TuanMTruong/Senior_Design/arduino_code/README.md

# gratis

## Sketches

These are example programs that will compile and run on the following platforms

1. TI LaunchPad with M430G2553 using the [Energia](https://github.com/energia) IDE
2. Arduino Leonardo using the [Arduino](http://arduino.cc) IDE

## PlatformWithOS

Contains an example driver and Python demo programs that can be
compiled and run on:

1. [Raspberry Pi](http://www.raspberrypi.org/).
2. [BeagleBone Black](http://www.beagleboard.org/)

======

Gratis is a Repaper.org repository, initiated by E Ink and PDI for the purpose of making sure ePaper can go everywhere.
