TuanMTruong/Senior_Design/proto_blocks/pwr_mgn/eagle_files/pwr_mgn-schematic.jpeg

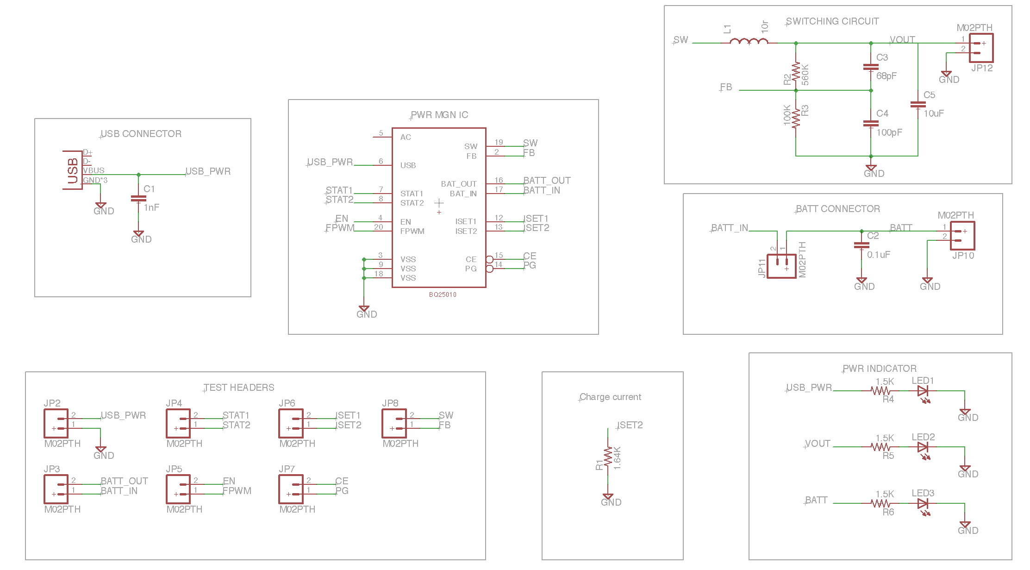
proto_blocks/pwr_mgn/eagle_files/pwr_mgn-schematic.jpeg
