TuanMTruong/Senior_Design/mainboard/BOM.xlsx

Board Ref. | Part Description | Block | Min. Qty. Needed | Qty. Needed + Spares | Cost (per unit) | Line Total | Supplier | Manufacturer Part Number | Purchase Link
BTN_0 - BTN_2 | surface mount/side mounting buttons | Button & LED | 3 | 6 | 0.75 | 4.5 | Digi-key | EVQ-PUK02K | http://www.digikey.com/product-detail/en/EVQ-PUK02K/P10852SCT-ND/286353
R7, R8, R9, R10 | RES 10K OHM 1/16W 5% 0402 | Button & LED | 4 | 12 | 0.02 | 0.24 | Digi-key | RMCF0402JT10K0 | http://www.digikey.com/product-detail/en/RMCF0402JT10K0/RMCF0402JT10K0CT-ND/1942936
R23, R24, R25, R26 | RES 100 OHM 1/16W 1% 0402 SMD | Button & LED | 4 | 12 | 0.1 | 1.2 | Digi-key | RC0402FR-07100RL | http://www.digikey.com/product-detail/en/RC0402FR-07100RL/311-100LRCT-ND/729474
D5, D6, D7, D8 | LED BLUE 0603 SMD | Button & LED | 4 | 12 | 0.47 | 5.64 | Digi-key | LTST-C193TBKT-5A | http://www.digikey.com/product-detail/en/LTST-C193TBKT-5A/160-1827-1-ND/2355044
EPD_CONN | FPC connector | Disp | 1 | 2 | 3.33 | 6.66 | Digi-key | FH12-40S-0.5SH(55) | http://www.digikey.com/product-detail/en/FH12-40S-0.5SH(55)/HFJ140CT-ND/1110388
U10 | AP2305GN P-CH MOSFET | Disp | 1 | 3 | 0.4 | 1.2 | Digi-key | DMG2305UX-13 | http://www.digikey.com/product-detail/en/DMG2305UX-13/DMG2305UX-13DICT-ND/4251589
C20 | 0.1uF 16V Y5V | Disp | 1 | 3 | 0.1 | 0.3 | Digi-key | CL05F104ZO5NNNC | http://www.digikey.com/product-detail/en/CL05F104ZO5NNNC/1276-1004-1-ND/3889090
C14 | 0.1uF 16V X7R | Disp | 1 | 3 | 0.1 | 0.3 | Digi-key | EMK105B7104KV-F | http://www.digikey.com/product-detail/en/EMK105B7104KV-F/587-1451-1-ND/1004082
C21 | 1uF 10V X7R | Disp | 1 | 3 | 0.1 | 0.3 | Digi-key | LMK105BJ105KV-F | http://www.digikey.com/product-detail/en/LMK105BJ105KV-F/587-1454-1-ND/1004085
C3, C19 | 2.2uF 10V Y5V | Disp | 2 | 6 | 0.2 | 1.2 | Digi-key | C0402C225M8PACTU | http://www.digikey.com/product-detail/en/C0402C225M8PACTU/399-7375-1-ND/3317409
C4, C5, C8, C10, C11, C12, C13, C17, C18 | 2.2uF 16V Y5V | Disp | 9 | 27 | 0.32 | 8.64 | Digi-key | C1005X5R1C225M050BC | http://www.digikey.com/product-detail/en/C1005X5R1C225M050BC/445-9076-1-ND/3661603
C6, C8, C9, C15, C16 | 2.2uF 25V Y5V | Disp | 5 | 15 | 0.36 | 5.4 | Digi-key | C1005X5R1E225M050BC | http://www.digikey.com/product-detail/en/C1005X5R1E225M050BC/445-9109-1-ND/3661595
D3 | BAT54SW diode SOT-323(SC-70) | Disp | 1 | 3 | 0.28 | 0.84 | Digi-key | BAT54SWT-TP | http://www.digikey.com/product-detail/en/BAT54SWT-TP/BAT54SWT-TPCT-ND/819661
Q4, Q5 | BSS84W P-CH MOSFET 50V/150mA SOT 23 | Disp | 2 | 6 | 0.22 | 1.32 | Digi-key | BSS84 | http://www.digikey.com/product-detail/en/BSS84/BSS84CT-ND/244297
Q1, Q2, Q3, Q7 | N7002KW N-CH MOSFET | Disp | 4 | 12 | 0.39 | 4.68 | Digi-key | 2N7002W-TP | http://www.digikey.com/product-detail/en/2N7002W-TP/2N7002W-TPMSCT-ND/2041564
R15 | 0 ohm 5% 1/16W | Disp | 1 | 3 | 0.1 | 0.3 | Digi-key | RC0402JR-070RL | http://www.digikey.com/product-detail/en/RC0402JR-070RL/311-0.0JRCT-ND/729353
R11 | 2K 5% 1/10W | Disp | 1 | 3 | 0.1 | 0.3 | Digi-key | ERJ-2GEJ202X | http://www.digikey.com/product-detail/en/ERJ-2GEJ202X/P2.0KJCT-ND/146957
R12, R13, R14 | 100K 5% 1/16W | Disp | 3 | 9 | 0.1 | 0.9 | Digi-key | RC0402JR-07100KL | http://www.digikey.com/product-detail/en/RC0402JR-07100KL/311-100KJRCT-ND/729363
R17 | 33K 5% 1/16W | Disp | 1 | 3 | 0.1 | 0.3 | Digi-key | RC0402JR-0733KL | http://www.digikey.com/product-detail/en/RC0402JR-0733KL/311-33KJRCT-ND/729415
n/a | APDS-9008 light sensor peak wave. 565nm | sensor | 0 | 2 | 1.23 | 2.46 | Digi-key | APDS-9008-020 | http://www.digikey.com/product-detail/en/APDS-9008-020/516-2662-1-ND/3909167
n/a | MCP6001 OPAMP SOT23-5 | sensor | 0 | 4 | 0.29 | 1.16 | Digi-key | MCP6001 | http://www.digikey.com/product-detail/en/MCP6001UT-I%2FOT/MCP6001UT-I%2FOTCT-ND/697159
n/a | LED Green wave. 505nm | sensor | 0 | 5 | 0.67 | 3.35 | Digi-key | WP7113WG1C | http://www.digikey.com/product-detail/en/WP7113WG1C/754-1607-ND/2771874
n/a | LED cyan 505nm | sensor | 0 | 3 | 3.64 | 10.92 | Mouser | LXML-PE01-0060 | http://www.mouser.com/ProductDetail/Philips-Lumileds/LXML-PE01-0060/ | X
n/a | APDS-9006 light sensor peak wave. 500nm | sensor | 0 | 2 | 1.39 | 2.78 | Digi-key | APDS-9006-020 | http://www.digikey.com/product-detail/en/APDS-9006-020/516-1718-1-ND/1785438
L1 | INDUCTOR POWER 10UH 0428 SMD | pwr_mgn | 1 | 3 | 0.88 | 2.64 | Digi-key | ASPI-0428S-100M-T | http://www.digikey.com/product-detail/en/ASPI-0428S-100M-T/ASPI-0428S-100M-TCT-ND/3060211
R1 | RES 56K OHM 1/10W 5% 0402 SMD | pwr_mgn | 1 | 3 | 0.1 | 0.3 | Digi-key | ERJ-2GEJ563X | http://www.digikey.com/product-detail/en/ERJ-2GEJ563X/P56KJCT-ND/147041
R2 | RES 10K OHM 1/10W 5% 0402 SMD | pwr_mgn | 1 | 3 | 0.1 | 0.3 | Digi-key | ERJ-2GEJ103X | http://www.digikey.com/product-detail/en/ERJ-2GEJ103X/P10KJCT-ND/146734
R3, R4 | RES 1.5K OHM 1/16W 5% 0402 | pwr_mgn | 2 | 6 | 0.02 | 0.12 | Digi-key | RMCF0402JT1K50 | http://www.digikey.com/product-detail/en/RMCF0402JT1K50/RMCF0402JT1K50CT-ND/2417846
R5 | RES 1.6K OHM 1/16W 5% 0402 | pwr_mgn | 1 | 3 | 0.02 | 0.06 | Digi-key | RMCF0402JT1K60 | http://www.digikey.com/product-detail/en/RMCF0402JT1K60/RMCF0402JT1K60CT-ND/2417847
R6 | RES 10K OHM 1/16W 5% 0402 | pwr_mgn | 1 | 3 | 0.02 | 0.06 | Digi-key | RMCF0402JT10K0 | http://www.digikey.com/product-detail/en/RMCF0402JT10K0/RMCF0402JT10K0CT-ND/1942936
D1, D2 | LED RED ORAN CLEAR THIN 0603 SMD | pwr_mgn | 2 | 10 | 0.29 | 2.9 | Digi-key | LTST-C191KFKT | http://www.digikey.com/product-detail/en/LTST-C191KFKT/160-1445-1-ND/386832
D9 | DIODE FAST REC 400V 1A MINISMA | pwr_mgn | 1 | 3 | 0.46 | 1.38 | Digi-key | CFRM104-HF | http://www.digikey.com/product-detail/en/CFRM104-HF/641-1487-1-ND/4248870
C2 | CAP CER 10UF 6.3V 10% X5R 0603 | pwr_mgn | 1 | 3 | 0.44 | 1.32 | Digi-key | C1608X5R0J106K080AB | http://www.digikey.com/product-detail/en/C1608X5R0J106K080AB/445-7492-1-ND/2733564
JP1 | CONN RCPT STD MICRO USB TYPE B | pwr_mgn | 1 | 3 | 0.79 | 2.37 | Digi-key | 10104110-0001LF | http://www.digikey.com/product-detail/en/10104110-0001LF/609-4052-1-ND/2350358
U3 | Li-ON pwr management | pwr_mgn | 1 | 3 | 0 | 0 | TI | BQ25010 | http://www.ti.com/product/bq25010
U2 | Bluetooth communication IC | bluetooth | 1 | 1 | 15.95 | 15.95 | Sparkfun | RN-42 | https://www.sparkfun.com/products/10253
C30, C25 | CAP CER 0.47UF 25V Y5V 0603 | mcu | 2 | 6 | 0.1 | 0.6 | Digi-key | TMK107F474ZA-T | http://www.digikey.com/product-detail/en/TMK107F474ZA-T/587-1259-1-ND/931036
U1 | 16 bit mcu MSP430F5528 | mcu | 1 | 3 | 0 | 0 | TI | MSP430F5528 | http://www.ti.com/product/msp430f5528
X1 | 32.768 Khz Crystal | mcu | 1 | 2 | 1.31 | 2.62 | Digi-key | ECS-.327-6-17X-TR | http://www.digikey.com/product-detail/en/ECS-.327-6-17X-TR/XC1307CT-ND/827771
C31, C32 | 12pF caps | mcu | 2 | 6 | 0.1 | 0.2 | Digi-key | CL05C120JB5NNNC | http://www.digikey.com/product-detail/en/CL05C120JB5NNNC/1276-1178-1-ND/3889264
R19, R20, R22 | RES 10K OHM 1/16W 5% 0402 | pwr_mon | 3 | 9 | 0.02 | 0.18 | Digi-key | RMCF0402JT10K0 | http://www.digikey.com/product-detail/en/RMCF0402JT10K0/RMCF0402JT10K0CT-ND/1942936
R21 | RES 1.8M OHM 1/10W 5% 0402 SMD | pwr_mon | 1 | 3 | 0.1 | 0.3 | Digi-key | ERJ-2GEJ185X | http://www.digikey.com/product-detail/en/ERJ-2GEJ185X/P1.8MJCT-ND/146923
R18 | RES 0.01 OHM 1/8W 1% 0402 | pwr_mon | 1 | 2 | 1.04 | 2.08 | Digi-key | CSRF0402FT10L0 | http://www.digikey.com/product-detail/en/CSRF0402FT10L0/CSRF0402FT10L0CT-ND/3945095
U9 | System-Side Impedance Trac Fuel Gauge | pwr_mon | 1 | 3 | 0 | 0 | TI | BQ27410 | http://www.ti.com/product/bq27410-g1
C1, C22, C23, C24, C26, C27, C28, C29 | CAP CER 0.1UF 10V 10% X5R 0402 | all blocks | 8 | 24 | 0.1 | 2.4 | Digi-key | C1005X5R1A104K050BA | http://www.digikey.com/product-detail/en/C1005X5R1A104K050BA/445-1265-1-ND/567732
 |  |  |  |  | Total (min. needed) | 39.69
 |  |  |  |  | TOTAL | 100.67
