TuanMTruong/Senior_Design/mcu_code/epd/EPD_BOM.xlsx

EPD-extension-board-05-03
Item | Name | Description | Type | Vender | Q'ty | Reference Designator | Remark
1 | SMD CAP | 0.1uF 16V | 0402/Y5V |  | 3 | C3,C7,C9
2 | SMD CAP | 0.1uF 16V | 0603/Y5V |  | 3 | C8,C27,C29
3 | SMD CAP | 0.1uF 16V | 0603/X7R |  | 1 | C26
4 | SMD CAP | 1uF 10V | 0805/X7R |  | 1 | C21
5 | SMD CAP | 2.2uF 10V | 0805/Y5V |  | 2 | C1,C10,
6 | SMD CAP | 2.2uF 16V | 0805/Y5V |  | 11 | C11,C12,C14,C17,C18,C19,C20,C24,C25,C28,C30
7 | SMD CAP | 2.2uF 25V | 0805/Y5V |  | 5 | C13,C15,C16,C22,C23
8 | Diode | DIODE BAT54SW | SOT-323(SC-70) |  | 1 | D1
9 | FPC connector | CONN 089H40-000000-G2-C | ZIF-40-0.5-1 |  | 1 | J4 | http://www.mouser.com/Search/ProductDetail.aspx?qs=nSryOFbzj8KFWylXg1bheA%3D%3D
10 | MOSFET | T/R AP2305GN P-CH | SOT23 |  | 1 | Q1
11 | MOSFET | MOSFET BSS84W P-Channel 50V/150mA | SOT-323 |  | 2 | Q3,Q7
12 | MOSFET | MOSFET @N7002KW N-Channel | SOT-323 |  | 9 | Q2,Q4,Q5,Q6,Q8,Q9,Q10,Q11,Q12 | NC:Q13,Q14
13 | SMD RES | 0 ohm | 0603 5% 1/16W |  | 2 | R32,R33 | NC:R34
14 | SMD RES | 2K ohm | 0603 5% 1/10W |  | 1 | R9
15 | SMD RES | 26.7K ohm | 0603 1% 1/10W |  | 1 | R4
16 | SMD RES | 17.8K ohm | 0603 1% 1/10W |  | 1 | R5
17 | SMD RES | 4.7k ohm | 0603 5% 1/16W |  | 1 | R16
18 | SMD RES | 100k ohm | 0402 5% 1/16W |  | 3 | R10,R11,R12
19 | SMD RES | 33k ohm | 0402 5% 1/16W |  | 1 | R1 | NC:R2
20 | SMD RES | 0 ohm | 0402 5% 1/16W |  | 8 | R6,R7,R8,R13,R14,R15,R28,R29 | NC: R3,R35,R36,R37,R38,R39
21 | SMD RES | 4.7k ohm | 0402 5% 1/16W |  | 9 | R17,R18,R19,R20,R21,R22,R23,R24,R25 | NC:R26,R27,R30,R31
22 | IC | S-5813A-I4T1G |  | Seiko | 1 | U1
23 | IC | MX25V8006M1I-13G SOP-8 Flash |  | MXIC | 1 | U2
24 | IC | TPS77030 | SOT23-5 | TI | 1 | U3
25 | Connector | 排母 P2.54 SMT 1*10 H7.1 B TYPE GP |  |  | 2 | J1,J2 | FH.P2.54.SMT.1*10.H7.1mm.B type.G.ARC.5F12134BJ1900110
26 | Connector | Box Header P2.54 90 degress 2*10 GP |  |  | 1 | J3 | BH.P2.54.90度.2*10.平底型.G.ARC.5B12124G22300210
27 | PCB | EPD-extension-board-05 |  |  | 1 | PCB/EPD-extension-board-05
 |  |  |  |  | 74
