TuanMTruong/Senior_Design/proto_blocks/mcu/eagle_files/BOM.xlsx

Quantity | Ref | Description | Supplier | Supplier number | Manufacturer | Manufacturer Part Number | Unit Cost | Extended Cost
1 | C1 | CAP CER 0.47UF 25V Y5V 0603 | Digi-Key | 587-1259-1-ND | Taiyo Yuden | TMK107F474ZA-T | 0.1 | 0.1
2 | C2, C3 | CAP CER 0.1UF 25V Y5V 0603 | Digi-Key | 1276-1011-1-ND | Samsung Electro-Mechanics America, Inc | CL10F104ZA8NNNC | 0.1 | 0.3
4 | R1-R4 | RES 1.5K OHM 1/10W 5% 0603 | Digi-Key | RMCF0603JT1K50CT-ND | Stackpole Electronics Inc | RMCF0603JT1K50 | 0.02 | 0.08
1 | U1 | 16-Bit Ultra-Low-Power Microcontroller | TI | MSP430F5528 | TI | MSP430F5528 | 3.55 | 3.55
 |  |  |  |  |  | Total |  | 4.03
