TuanMTruong/Senior_Design/proto_blocks/pwr_mgn/eagle_files/BOM.xlsx

Quantity | Ref | Description | Supplier | Supplier number | Manufacturer | Manufacturer Part Number | Unit Cost | Extended Cost
1 | C1 | CAP CER 1000PF 50V 10% X7R 0603 | Digi-Key | 1276-1018-1-ND | Samsung Electro-Mechanics America, Inc | CL10B102KB8NNNC | 0.1 | 0.1
1 | C2 | CAP CER 0.1UF 25V Y5V 0603 | Digi-Key | 1276-1011-1-ND | Samsung Electro-Mechanics America, Inc | CL10F104ZA8NNNC | 0.1 | 0.1
1 | C3 | CAP CER 68PF 50V 1% NP0 0603 | Digi-Key | 399-7945-1-ND | Kemet | C0603C680F5GACTU | 0.22 | 0.22
1 | C4 | CAP CER 100PF 50V 2% NP0 0603 | Digi-Key | 1276-2161-1-ND | Samsung Electro-Mechanics America, Inc | CL10C101GB8NNNC | 0.13 | 0.13
1 | C5 | CAP CER 10UF 6.3V 20% X5R 0603 | Digi-Key | 1276-1119-1-ND | Samsung Electro-Mechanics America, Inc | CL10A106MQ8NNNC | 0.19 | 0.19
1 | JP1 | CONN RCPT STD MICRO USB TYPE B | Digi-Key | 609-4052-1-ND | FCI | 10104110-0001LF | 0.79 | 0.79
1 | L1 | INDUCTOR 10UH 10% 1210 SMD | Digi-Key | PCD1484CT-ND | Panasonic Electronic Components - Semiconductor Products | ELJ-PA100KF | 0.27 | 0.27
1 | LED1, LED2 | LED 1.6X0.8MM 631NM RED CLR SMD | Digi-Key | 754-1359-1-ND | Kingbright Company LLC | APG1608SURKC/T | 0.23 | 0.46
1 | LED3 | LED YELLOW GREEN HI BRT USS 0603 | Digi-Key | P13485CT-ND | Panasonic Electronic Components - Semiconductor Products | LNJ326W83RA | 0.44 | 0.44
1 | R1 | RES 1.62K OHM 1/10W 1% 0603 SMD | Digi-Key | P1.62KHCT-ND | Panasonic Electronic Components - Semiconductor Products | ERJ-3EKF1621V | 0.1 | 0.1
1 | R2 | RES 560K OHM 1/10W 5% 0603 SMD | Digi-Key | P560KGCT-ND | Panasonic Electronic Components - Semiconductor Products | ERJ-3GEYJ564V | 0.1 | 0.1
1 | R3 | RES 100K OHM 1/10W 5% 0603 | Digi-Key | RMCF0603JT100KCT-ND | Stackpole Electronics Inc | RMCF0603JT100K | 0.02 | 0.02
3 | R4, R5, R6 | RES 1.5K OHM 1/10W 5% 0603 | Digi-Key | RMCF0603JT1K50CT-ND | Stackpole Electronics Inc | RMCF0603JT1K50 | 0.02 | 0.06
1 | U1 | Single Chip Charger and DC/DC Converter IC | TI | BQ25010 | TI | BQ25010 | 3.89 | 3.89
 |  |  |  |  |  | Total |  | 6.87
