TuanMTruong/Senior_Design/(list of files, cad)

Other CAD files:
proto_blocks/bt_breakout/bt_441-tcream.dxf
proto_blocks/mcu/eagle_files/mcu_block.job-bcream.dxf
proto_blocks/pwr_mgn/eagle_files/pwr_block-tcream.dxf
proto_blocks/bt_breakout/bt_441-bcream.dxf
proto_blocks/mcu/eagle_files/mcu_block.job-tcream.dxf
proto_blocks/pwr_mgn/eagle_files/pwr_block-bcream.dxf
