TuanMTruong/Senior_Design/proto_blocks/sensor/sensor_2.pdf

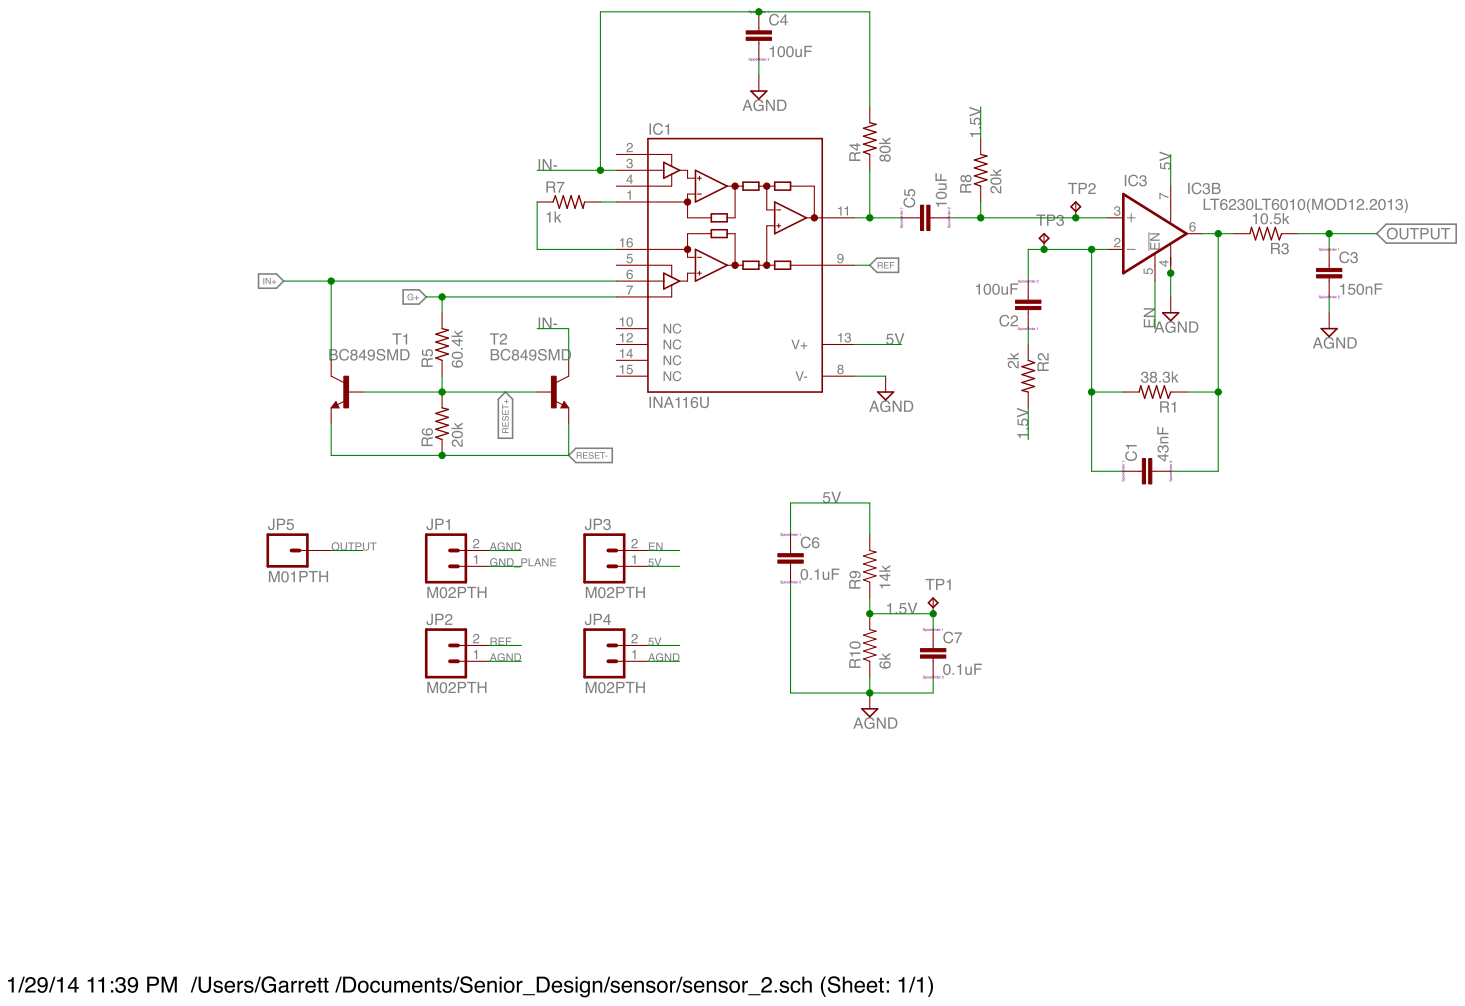
[picture p2: page 1]
