TuanMTruong/Senior_Design/proto_blocks/mcu/eagle_files/mcu_block.pdf

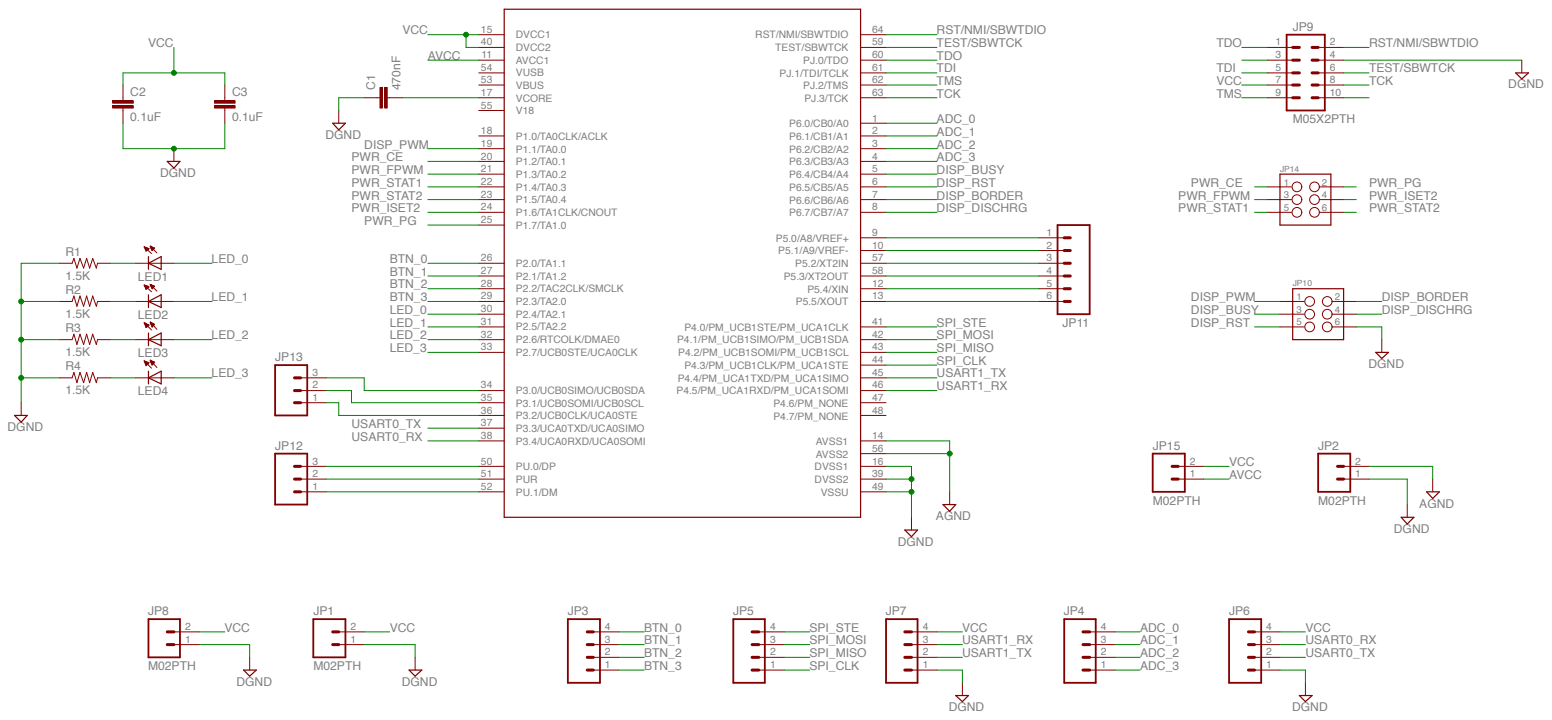
[picture p3: page 1]
