TuanMTruong/Senior_Design/proto_blocks/mcu/eagle_files/mcu_block.brd

## EAGLE design proto_blocks/mcu/eagle_files/mcu_block.brd (2013-12-21)

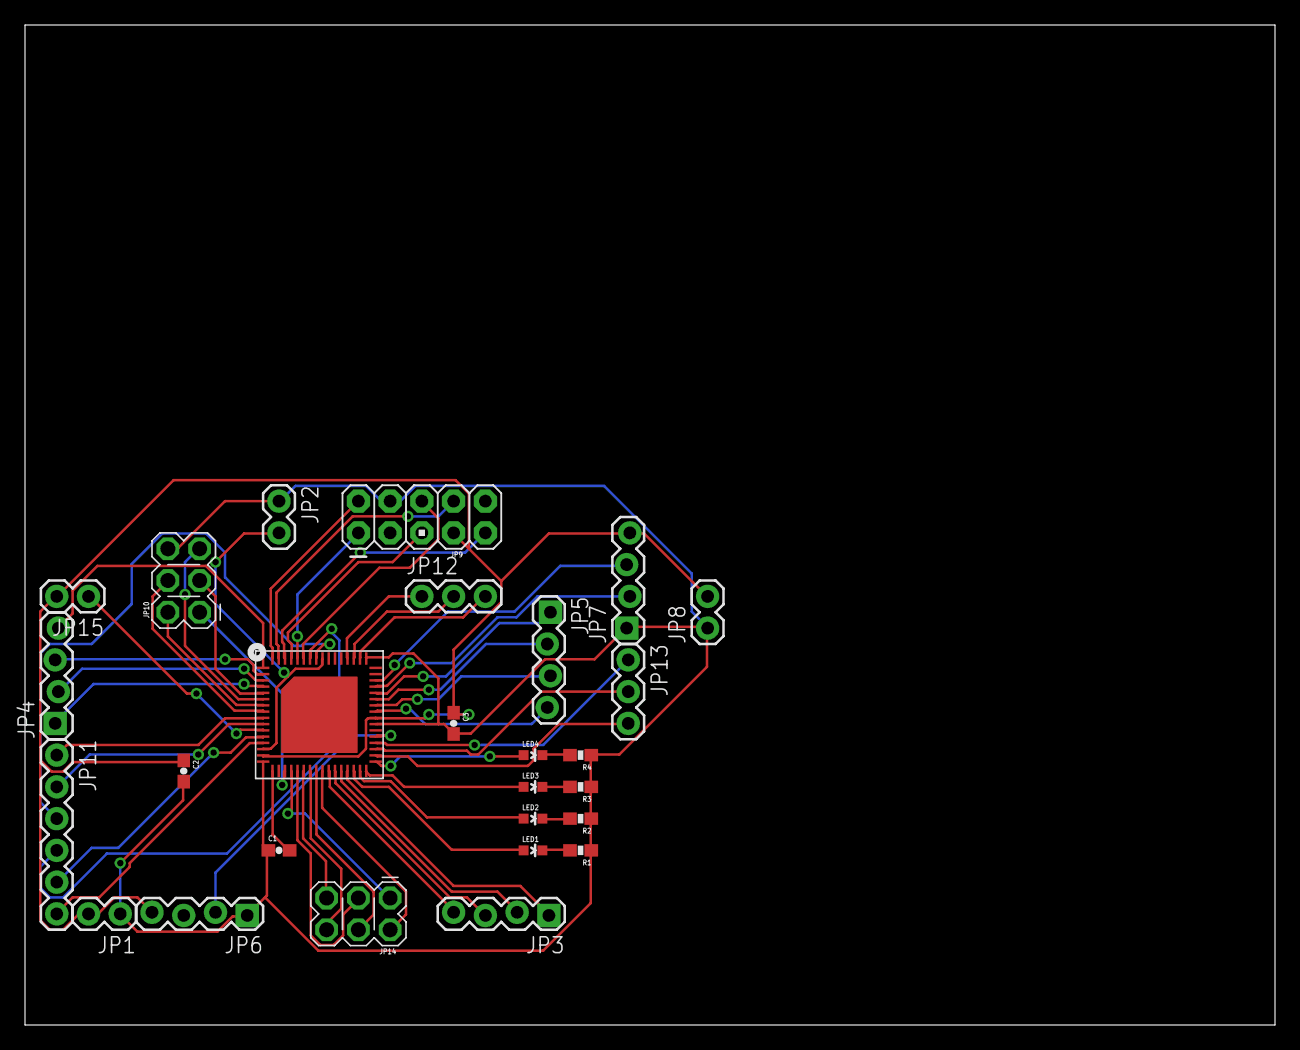
[picture p4: board mcu_block.brd from above]

Board: 2 copper layers, 100.0 x 80.0 mm, 27 parts (0 on the bottom side), 58 nets.

Parts:
C1: 470nF; 0603-CAP
C2, C3: 0.1uF; 0603-CAP
JP1, JP2, JP8, JP15: M02PTH; 1X02
JP3, JP4, JP5, JP6, JP7: 1X04_LOCK
JP9: M05X2PTH; AVR_ICSP
JP10, JP14: 2X3_POGO
JP11: 1X06
JP12, JP13: 1X03
LED1, LED2, LED3, LED4: LED-0603
R1, R2, R3, R4: 1.5K; 0603-RES
U$1: MSP430F5528; VQFN_RGC_64PIN

Connections:
ADC_0: JP4.4, U$1.1
ADC_1: JP4.3, U$1.2
ADC_2: JP4.2, U$1.3
ADC_3: JP4.1, U$1.4
AGND: JP2.2, U$1.14, U$1.56
AVCC: JP15.1, U$1.11
BTN_0: JP3.4, U$1.26
BTN_1: JP3.3, U$1.27
BTN_2: JP3.2, U$1.28
BTN_3: JP3.1, U$1.29
DGND: C1.1, C2.2, C3.2, JP1.1, JP2.1, JP6.1, JP7.1, JP8.1, JP9.4, JP10.P$6, R1.1, R2.1, R3.1, R4.1, U$1.16, U$1.39, U$1.49
DISP_BORDER: JP10.P$2, U$1.7
DISP_BUSY: JP10.P$3, U$1.5
DISP_DISCHRG: JP10.P$4, U$1.8
DISP_PWM: JP10.P$1, U$1.19
DISP_RST: JP10.P$5, U$1.6
LED_0: LED1.A, U$1.30
LED_1: LED2.A, U$1.31
LED_2: LED3.A, U$1.32
LED_3: LED4.A, U$1.33
unnamed: C1.2, U$1.17
unnamed: LED4.C, R4.2
unnamed: JP11.1, U$1.9
unnamed: JP11.2, U$1.10
unnamed: JP11.3, U$1.57
unnamed: JP11.4, U$1.58
unnamed: JP11.5, U$1.12
unnamed: JP11.6, U$1.13
unnamed: JP12.3, U$1.50
unnamed: JP12.2, U$1.51
unnamed: JP12.1, U$1.52
unnamed: JP13.1, U$1.36
unnamed: JP13.2, U$1.35
unnamed: JP13.3, U$1.34
unnamed: LED3.C, R3.2
unnamed: LED2.C, R2.2
unnamed: LED1.C, R1.2
PWR_CE: JP14.P$1, U$1.20
PWR_FPWM: JP14.P$3, U$1.21
PWR_ISET2: JP14.P$4, U$1.24
PWR_PG: JP14.P$2, U$1.25
PWR_STAT1: JP14.P$5, U$1.22
PWR_STAT2: JP14.P$6, U$1.23
RST/NMI/SBWTDIO: JP9.2, U$1.64
SPI_CLK: JP5.1, U$1.44
SPI_MISO: JP5.2, U$1.43
SPI_MOSI: JP5.3, U$1.42
SPI_STE: JP5.4, U$1.41
TCK: JP9.8, U$1.63
TDI: JP9.5, U$1.61
TDO: JP9.1, U$1.60
TEST/SBWTCK: JP9.6, U$1.59
TMS: JP9.9, U$1.62
USART0_RX: JP6.3, U$1.38
USART0_TX: JP6.2, U$1.37
USART1_RX: JP7.3, U$1.46
USART1_TX: JP7.2, U$1.45
VCC: C2.1, C3.1, JP1.2, JP6.4, JP7.4, JP8.2, JP9.7, JP15.2, U$1.15, U$1.40
