TuanMTruong/Senior_Design/proto_blocks/pwr_mgn/eagle_files/pwr_block.brd

## EAGLE design proto_blocks/pwr_mgn/eagle_files/pwr_block.brd (2014-01-02)

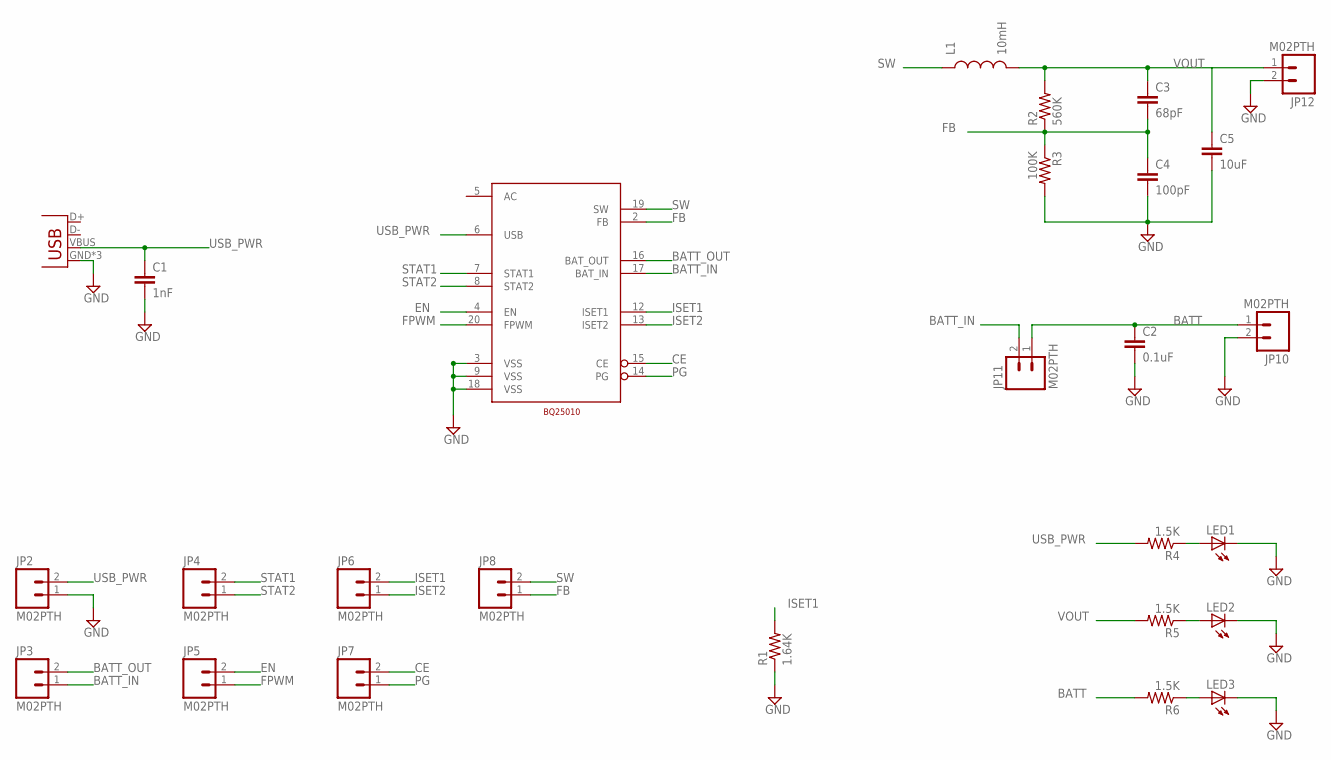
[picture p5: schematic pwr_block.sch]

Parts:
C1: 1nF; 0603-CAP
C2: 0.1uF; 0603-CAP
C3: 68pF; 0603-CAP
C4: 100pF; 0603-CAP
C5: 10uF; 0603-CAP
JP1: USB-MICROB
JP2, JP3, JP4, JP5, JP6, JP7, JP8, JP10, JP11, JP12: M02PTH; 1X02
L1: 10mH; 0603
LED1, LED2, LED3: LED0603; LED-0603
R1: 1.64K; 0603-RES
R2: 560K; 0603-RES
R3: 100K; 0603-RES
R4, R5, R6: 1.5K; 0603-RES
U$1: BQ25010; VQFN_RHL_20PIN

Connections:
BATT: C2.1, JP10.1, JP11.1, R6.2
BATT_IN: JP3.1, JP11.2, U$1.17 (BAT_IN)
BATT_OUT: JP3.2, U$1.16 (BAT_OUT)
CE: JP7.2, U$1.15 (CE)
EN: JP5.2, U$1.4 (EN)
FB: C3.2, C4.1, JP8.1, R2.1, R3.1, U$1.2 (FB)
FPWM: JP5.1, U$1.20 (FPWM)
GND: C1.2, C2.2, C4.2, C5.2, JP1.GND, JP1.MT1 (GND), JP1.MT2 (GND), JP2.1, JP10.2, JP12.2, LED1.C, LED2.C, LED3.C, R1.1, R3.2, U$1.3 (VSS), U$1.9 (VSS), U$1.18 (VSS)
ISET1: JP6.2, R1.2, U$1.12 (ISET1)
ISET2: JP6.1, U$1.13 (ISET2)
unnamed: LED1.A, R4.1
unnamed: LED2.A, R5.1
unnamed: LED3.A, R6.1
PG: JP7.1, U$1.14 (PG)
STAT1: JP4.2, U$1.7 (STAT1)
STAT2: JP4.1, U$1.8 (STAT2)
SW: JP8.2, L1.1, U$1.19 (SW)
USB_PWR: C1.1, JP1.VBUS, JP2.2, R4.2, U$1.6 (USB)
VOUT: C3.1, C5.1, JP12.1, L1.2, R2.2, R5.2

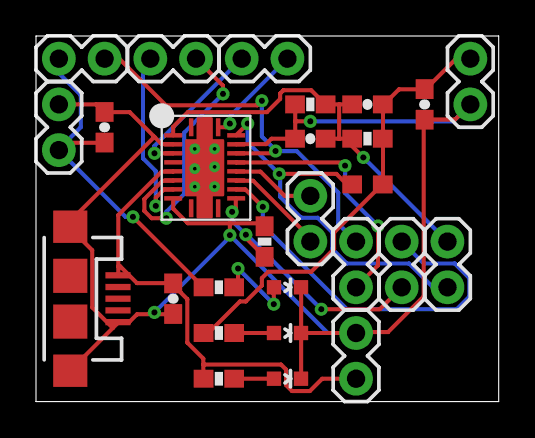
[picture p6: board pwr_block.brd from above]

Board: 2 copper layers, 25.7 x 20.3 mm, 27 parts (0 on the bottom side), 19 nets.
