TuanMTruong/Senior_Design/proto_blocks/bt_breakout/bt_441.brd

## EAGLE design proto_blocks/bt_breakout/bt_441.brd (2014-01-13)

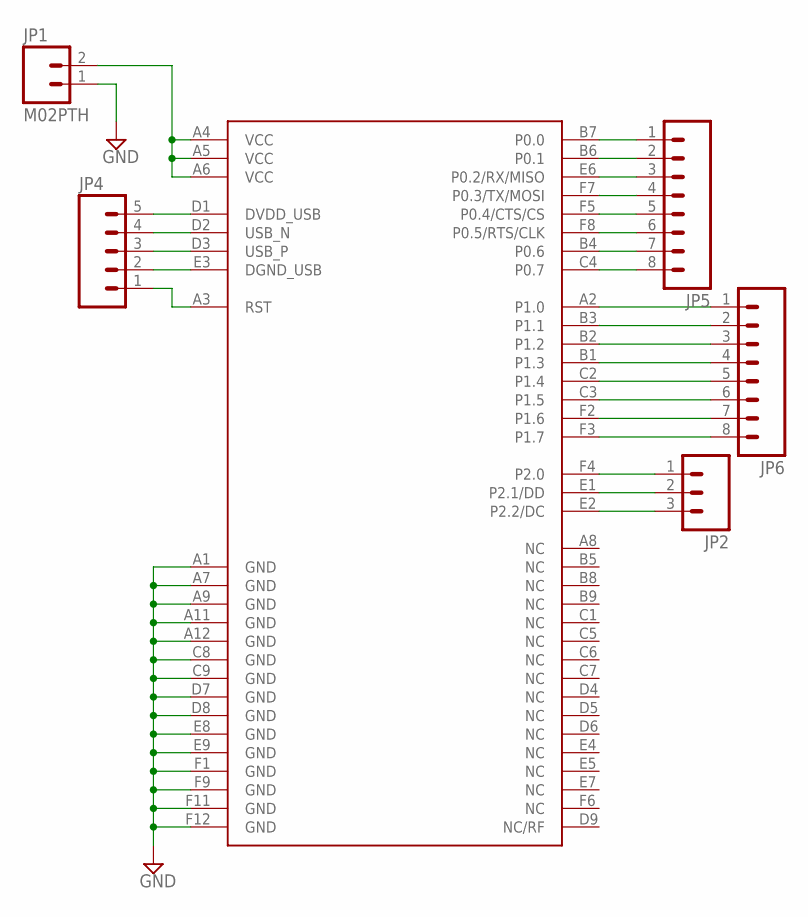
[picture p7: schematic bt_441.sch]

Parts:
JP1: M02PTH; 1X02
JP2: M03PTH; 1X03
JP4: M05PTH; 1X05
JP5, JP6: M081X08; 1X08
U$1: PAN1720

Connections:
GND: JP1.1, U$1.A1 (GND), U$1.A7 (GND), U$1.A9 (GND), U$1.A11 (GND), U$1.A12 (GND), U$1.C8 (GND), U$1.C9 (GND), U$1.D7 (GND), U$1.D8 (GND), U$1.E8 (GND), U$1.E9 (GND), U$1.F1 (GND), U$1.F9 (GND), U$1.F11 (GND), U$1.F12 (GND)
unnamed: JP1.2, U$1.A4 (VCC), U$1.A5 (VCC), U$1.A6 (VCC)
unnamed: JP4.5, U$1.D1 (DVDD_USB)
unnamed: JP4.4, U$1.D2 (USB_N)
unnamed: JP4.3, U$1.D3 (USB_P)
unnamed: JP4.2, U$1.E3 (DGND_USB)
unnamed: JP4.1, U$1.A3 (RST)
unnamed: JP5.1, U$1.B7 (P0.0)
unnamed: JP5.2, U$1.B6 (P0.1)
unnamed: JP5.3, U$1.E6 (P0.2/RX/MISO)
unnamed: JP5.4, U$1.F7 (P0.3/TX/MOSI)
unnamed: JP5.5, U$1.F5 (P0.4/CTS/CS)
unnamed: JP5.6, U$1.F8 (P0.5/RTS/CLK)
unnamed: JP5.7, U$1.B4 (P0.6)
unnamed: JP5.8, U$1.C4 (P0.7)
unnamed: JP6.1, U$1.A2 (P1.0)
unnamed: JP6.2, U$1.B3 (P1.1)
unnamed: JP6.3, U$1.B2 (P1.2)
unnamed: JP6.4, U$1.B1 (P1.3)
unnamed: JP6.5, U$1.C2 (P1.4)
unnamed: JP6.6, U$1.C3 (P1.5)
unnamed: JP6.7, U$1.F2 (P1.6)
unnamed: JP6.8, U$1.F3 (P1.7)
unnamed: JP2.1, U$1.F4 (P2.0)
unnamed: JP2.2, U$1.E1 (P2.1/DD)
unnamed: JP2.3, U$1.E2 (P2.2/DC)

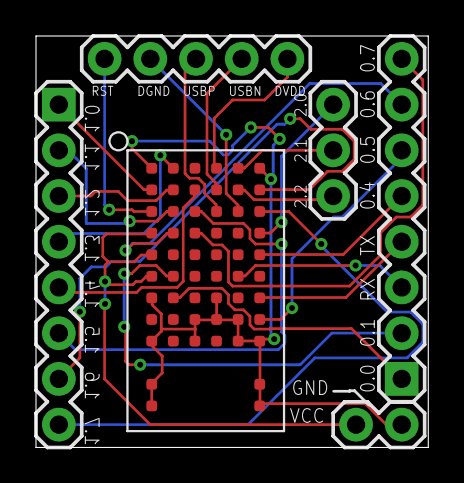
[picture p8: board bt_441.brd from above]

Board: 2 copper layers, 21.8 x 22.9 mm, 6 parts (0 on the bottom side), 26 nets.
