TuanMTruong/Senior_Design/proto_blocks/sensor/sensor_2.brd

## EAGLE design proto_blocks/sensor/sensor_2.brd (2014-01-02)

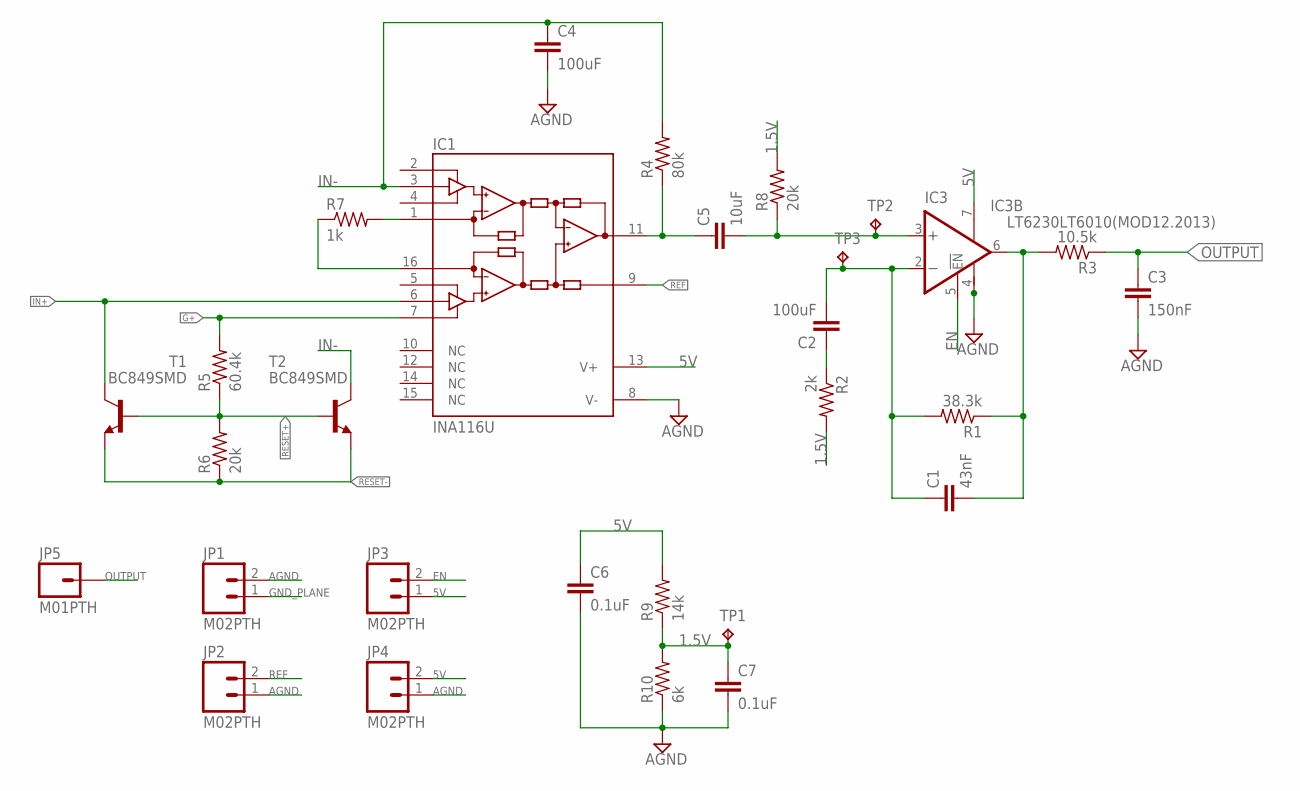
[picture p9: schematic sensor_2.sch]

Parts:
C1: 43nF; C0805
C2, C4: 100uF; C1206
C3: 150nF; C0603
C5: 10uF; C1206
C6, C7: 0.1uF; C0402
IC1: INA116U; SO16-1
IC3: LT6230LT6010(MOD12.2013); DFN8-3X3(MODIFIED12.2013)
JP1, JP2, JP3, JP4: M02PTH; 1X02
JP5: M01PTH; 1X01
R1: 38.3k; R0805
R2: 2k; R0805
R3: 10.5k; R0805
R4: 80k; R0805
R5: 60.4k; R0603
R6, R8: 20k; R0603
R7: 1k; R0402
R9: 14k; 0603-RES
R10: 6k; 1206
T1, T2: BC849SMD; SOT23-BEC
TP1, TP2, TP3: TPPAD1-13; P1-13

Connections:
1.5V: C7.1, R2.2, R8.2, R9.1, R10.2, TP1.TP
5V: C6.1, IC1.13 (V+), IC3.7 (V+), JP3.1, JP4.2, R9.2
AGND: C3.2, C4.2, C6.2, C7.2, IC1.8 (V-), IC3.4 (V-), JP1.2, JP2.1, JP4.1, R10.1
EN: IC3.5 (!EN), JP3.2
G+: IC1.7 (GUARD+), R5.2
GND_PLANE: JP1.1
IN+: IC1.6 (+IN), T1.C
IN-: C4.1, IC1.3 (-IN), R4.2, T2.C
unnamed: IC1.1 (RG), R7.2
unnamed: IC1.16 (RG), R7.1
unnamed: C5.1, IC1.11 (OUT), R4.1
unnamed: C2.1, R2.1
unnamed: C1.1, C2.2, IC3.2 (-IN), R1.2, TP3.TP
unnamed: C5.2, IC3.3 (+IN), R8.1, TP2.TP
unnamed: C1.2, IC3.6 (OUT), R1.1, R3.2
OUTPUT: C3.1, JP5.1, R3.1
REF: IC1.9 (REF), JP2.2
RESET+: R5.1, R6.2, T1.B, T2.B
RESET-: R6.1, T1.E, T2.E

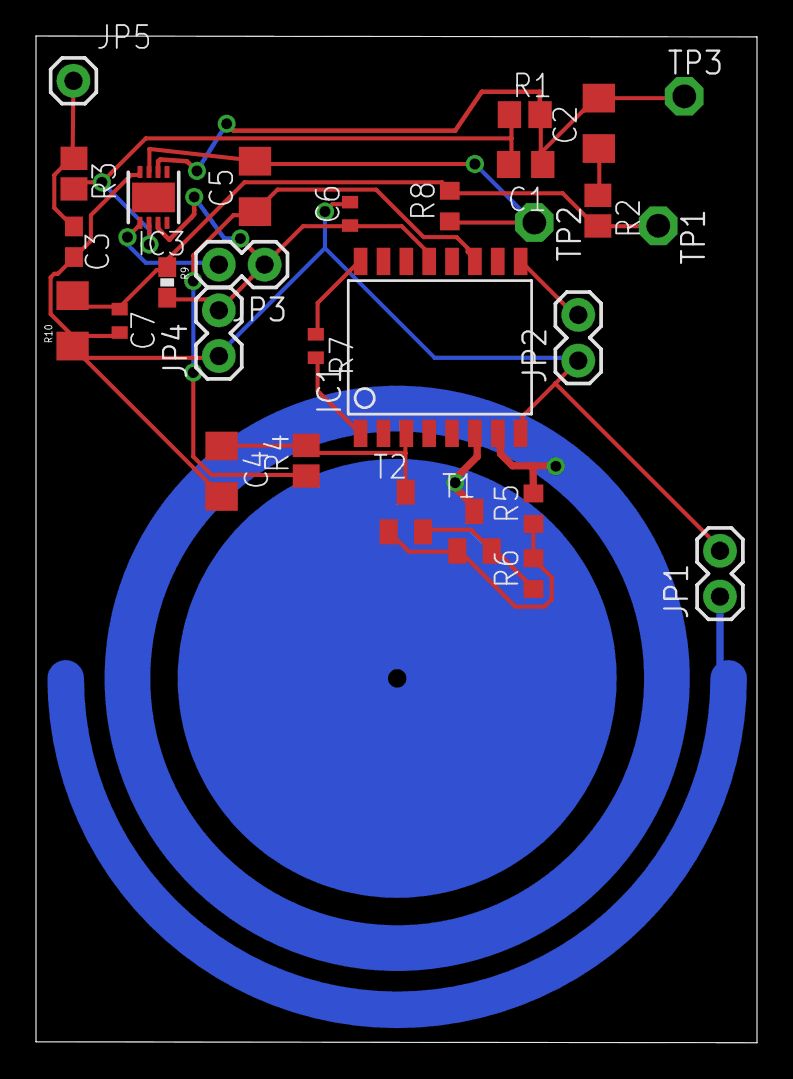
[picture p10: board sensor_2.brd from above]

Board: 2 copper layers, 40.1 x 55.9 mm, 29 parts (0 on the bottom side), 18 nets.
