TuanMTruong/Senior_Design/mainboard/rev2/mainboard.brd

## EAGLE design mainboard/rev2/mainboard.brd (2014-04-25)

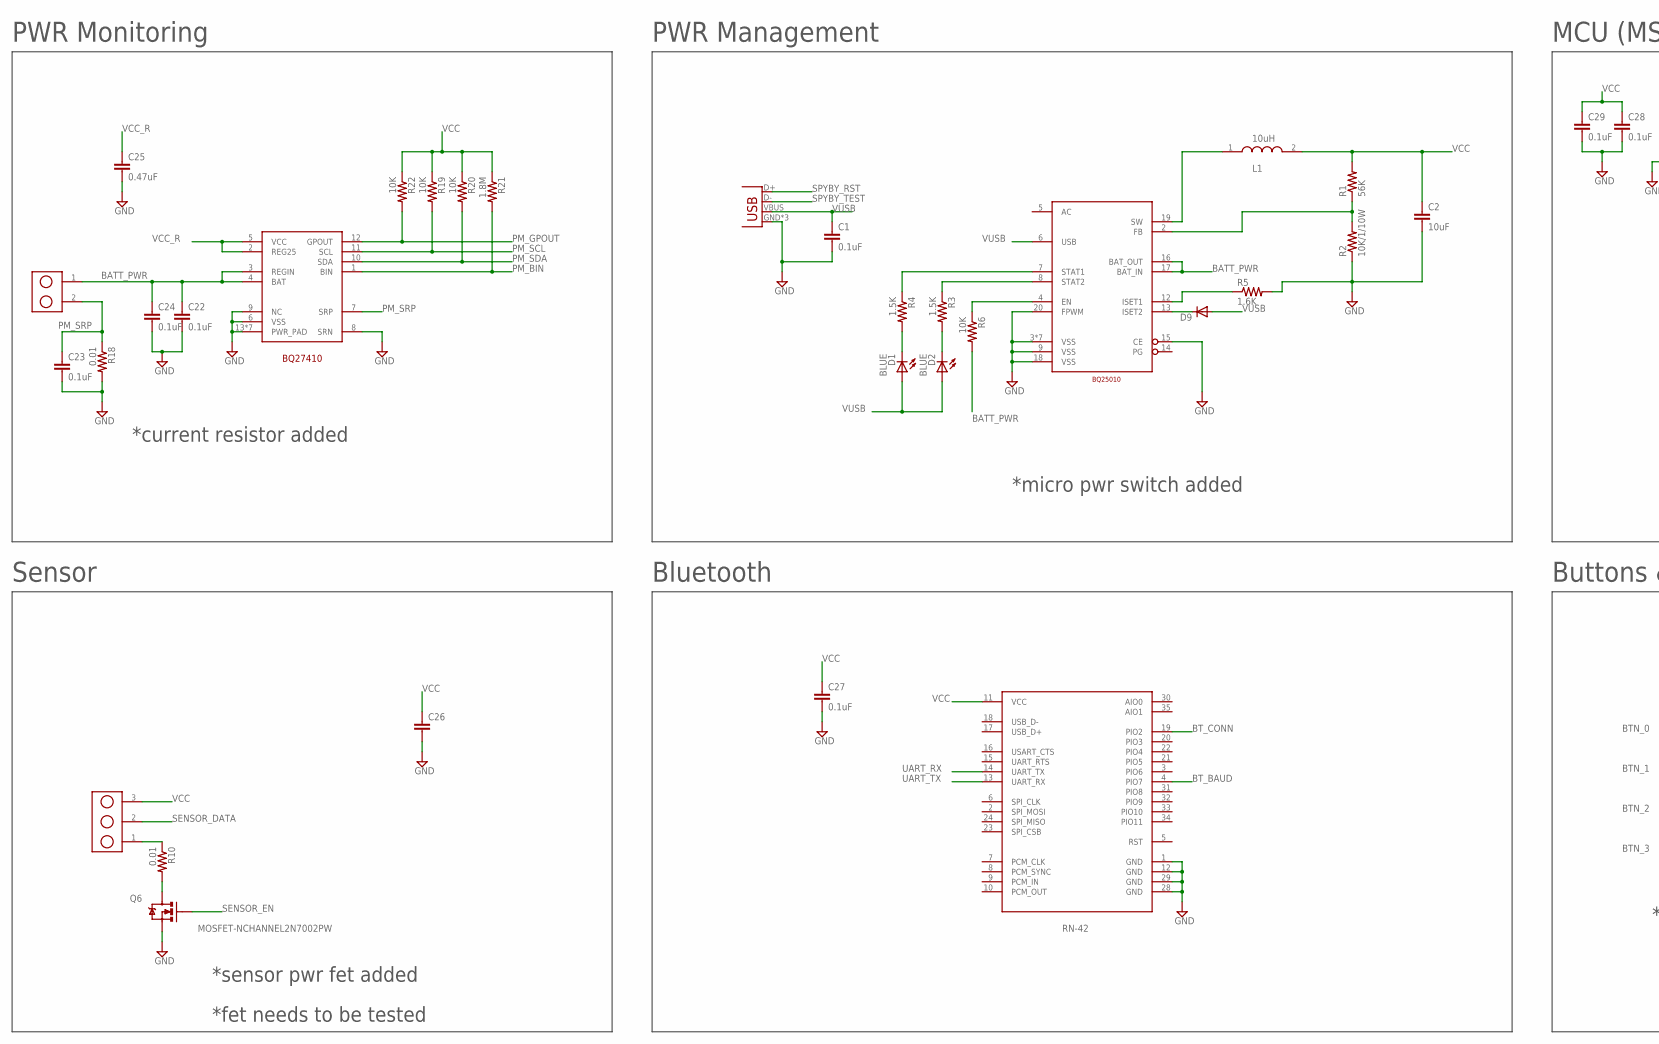
[picture p11: schematic mainboard.sch, part in row 1, column 1]

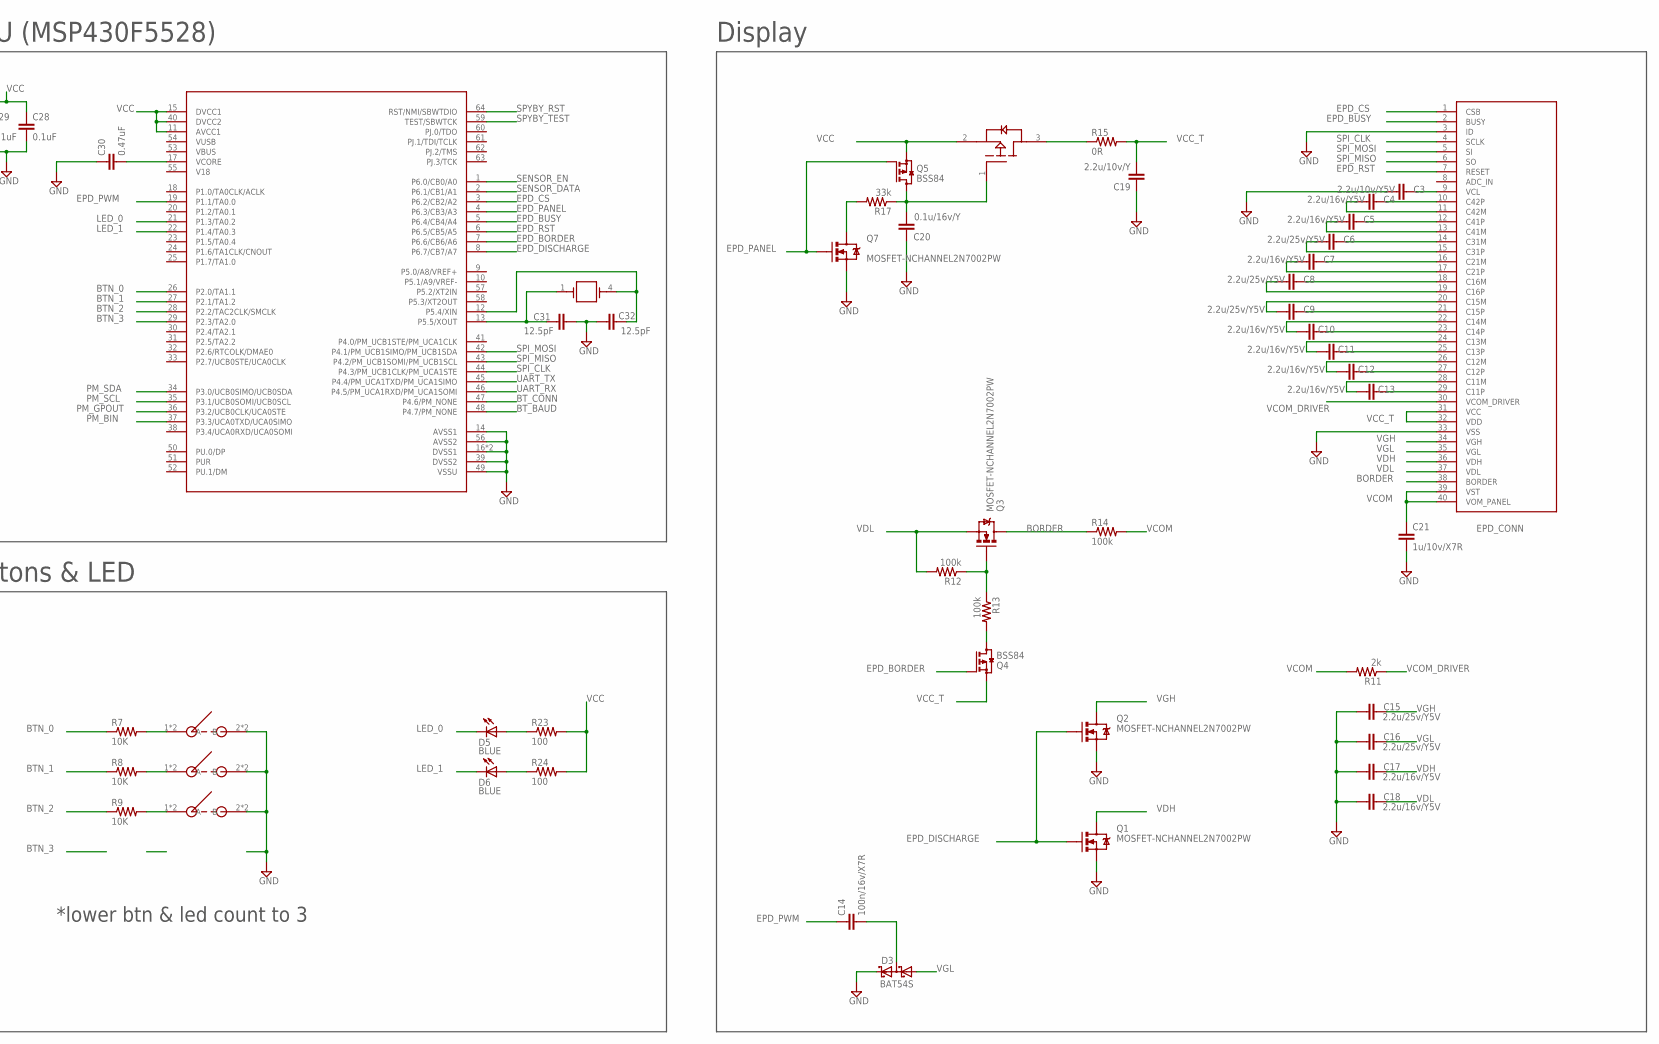
[picture p12: schematic mainboard.sch, part in row 1, column 2]

Parts:
AP2305: DMG2305UX; SOT23
C1, C22, C23, C24, C27, C28, C29: 0.1uF; 0402-CAP
C2: 10uF; 0402-CAP
C3: 2.2u/10v/Y5V; 0402-CAP
C4, C5, C7, C10, C11, C12, C13, C17, C18: 2.2u/16v/Y5V; 0402-CAP
C6, C8, C9, C15, C16: 2.2u/25v/Y5V; 0402-CAP
C14: 100n/16v/X7R; 0402-CAP
C19: 2.2u/10v/Y; 0402-CAP
C20: 0.1u/16v/Y; 0402-CAP
C21: 1u/10v/X7R; 0402-CAP
C25, C30: 0.47uF; 0402-CAP
C26: CAP0402-CAP; 0402-CAP
C31, C32: 12.5pF; 0402-CAP
D1, D2, D5, D6: BLUE; LED-0603
D3: BAT54S; SOT23
D9: DIODESOD523; SOD523
JP1: USB-MICROB
L1: 10uH; ASPI_0428S-100M-T
Q1, Q2, Q3, Q6, Q7: MOSFET-NCHANNEL2N7002PW; SOT323
Q4, Q5: BSS84; SOT23
R1: 56K; 0402-RES
R2: 10K/1/10W; 0402-RES
R3, R4: 1.5K; 0402-RES
R5: 1.6K; 0402-RES
R6, R7, R8, R9, R19, R20, R22: 10K; 0402-RES
R10, R18: 0.01; 0402-RES
R11: 2k; 0402-RES
R12, R13, R14: 100k; 0402-RES
R15: 0R; 0402-RES
R17: 33k; 0402-RES
R21: 1.8M; 0402-RES
R23, R24: 100; 0402-RES
U$1: MSP430F5528; VQFN_RGC_64PIN
U$2: RN-42
U$3: BQ25010; VQFN_RHL_20PIN
U$4, U$5, U$6: RA_TAC_BUTTON"EVQPUK"; EVQ-PUK02K; PART# EVQ-PUK02K
U$8: FH12-40S-0.5SH
U$9: BQ27410; SON_DRZ_12PIN
U$11: HEADER_2PIN_50MIL
U$12: HEADER_3PIN_50MIL
X1: CRYSTAL"32.768"; ECS-327-12.5-17X-C-TR

Connections:
BATT_PWR: C22.1, C24.1, R6.2, U$3.16 (BAT_OUT), U$3.17 (BAT_IN), U$9.3 (REGIN), U$9.4 (BAT), U$11.1
BORDER: Q3.3 (D), R14.1, U$8.38 (BORDER)
BTN_0: R7.1, U$1.26 (P2.0/TA1.1)
BTN_1: R8.1, U$1.27 (P2.1/TA1.2)
BTN_2: R9.1, U$1.28 (P2.2/TAC2CLK/SMCLK)
BTN_3: U$1.29 (P2.3/TA2.0)
BT_BAUD: U$1.48 (P4.7/PM_NONE), U$2.4 (PIO7)
BT_CONN: U$1.47 (P4.6/PM_NONE), U$2.19 (PIO2)
EPD_BORDER: Q4.1 (G), U$1.7 (P6.6/CB6/A6)
EPD_BUSY: U$1.5 (P6.4/CB4/A4), U$8.2 (BUSY)
EPD_CS: U$1.3 (P6.2/CB2/A2), U$8.1 (CSB)
EPD_DISCHARGE: Q1.1 (G), Q2.1 (G), U$1.8 (P6.7/CB7/A7)
EPD_PANEL: Q5.1 (G), Q7.1 (G), U$1.4 (P6.3/CB3/A3)
EPD_PWM: C14.1, U$1.19 (P1.1/TA0.0)
EPD_RST: U$1.6 (P6.5/CB5/A5), U$8.7 (RESET)
GND: C1.2, C2.2, C3.1, C15.1, C16.1, C17.1, C18.1, C19.1, C20.1, C21.2, C22.2, C23.2, C24.2, C25.2, C26.2, C27.2, C28.2, C29.2, C30.1, C31.2, C32.1, D3.2 (C2), JP1.GND, JP1.MT1 (GND), JP1.MT2 (GND), Q1.2 (S), Q2.2 (S), Q6.2 (S), Q7.2 (S), R2.1, R5.2, R18.2, U$1.14 (AVSS1), U$1.16 (DVSS1), U$1.39 (DVSS2), U$1.49 (VSSU), U$1.56 (AVSS2), U$1.P$1 (DVSS1), U$2.1 (GND), U$2.12 (GND), U$2.28 (GND), U$2.29 (GND), U$3.3 (VSS), U$3.9 (VSS), U$3.15 (CE), U$3.18 (VSS), U$3.20 (FPWM), U$3.P$21 (VSS), U$3.P$22 (VSS), U$3.P$23 (VSS), U$3.P$24 (VSS), U$3.P$25 (VSS), U$3.P$26 (VSS), U$4.2 (B), U$4.4 (B), U$5.2 (B), U$5.4 (B), U$6.2 (B), U$6.4 (B), U$8.3 (ID), U$8.33 (VSS), U$9.6 (VSS), U$9.8 (SRN), U$9.9 (NC), U$9.13 (PWR_PAD), U$9.P$15 (PWR_PAD), U$9.P$16 (PWR_PAD), U$9.P$17 (PWR_PAD), U$9.P$18 (PWR_PAD), U$9.P$19 (PWR_PAD), U$9.P$20 (PWR_PAD)
LED_0: D5.C, U$1.21 (P1.3/TA0.2)
LED_1: D6.C, U$1.22 (P1.4/TA0.3)
unnamed: R5.1, U$3.12 (ISET1)
unnamed: D1.C, R4.2
unnamed: D9.C, U$3.13 (ISET2)
unnamed: D2.C, R3.2
unnamed: R1.1, R2.2, U$3.2 (FB)
unnamed: L1.1, U$3.19 (SW)
unnamed: C30.2, U$1.17 (VCORE)
unnamed: Q4.3 (D), R13.2
unnamed: C14.2, D3.3 (C1A2)
unnamed: R4.1, U$3.7 (STAT1)
unnamed: R3.1, U$3.8 (STAT2)
unnamed: R6.1, U$3.4 (EN)
unnamed: R7.2, U$4.1 (A), U$4.3 (A)
unnamed: R8.2, U$5.1 (A), U$5.3 (A)
unnamed: R9.2, U$6.1 (A), U$6.3 (A)
unnamed: Q6.3 (D), R10.2
unnamed: R10.1, U$12.1
unnamed: C4.2, U$8.10 (C42P)
unnamed: C4.1, U$8.11 (C42M)
unnamed: C5.2, U$8.12 (C41P)
unnamed: C5.1, U$8.13 (C41M)
unnamed: C6.2, U$8.14 (C31M)
unnamed: C6.1, U$8.15 (C31P)
unnamed: C7.2, U$8.16 (C21M)
unnamed: C7.1, U$8.17 (C21P)
unnamed: C8.2, U$8.18 (C16M)
unnamed: C8.1, U$8.19 (C16P)
unnamed: C9.1, U$8.20 (C15M)
unnamed: C9.2, U$8.21 (C15P)
unnamed: C10.1, U$8.22 (C14M)
unnamed: C10.2, U$8.23 (C14P)
unnamed: C11.1, U$8.24 (C13M)
unnamed: C11.2, U$8.25 (C13P)
unnamed: C12.1, U$8.26 (C12M)
unnamed: C12.2, U$8.27 (C12P)
unnamed: C13.1, U$8.28 (C11M)
unnamed: C13.2, U$8.29 (C11P)
unnamed: C3.2, U$8.9 (VCL)
unnamed: AP2305.3 (DRAIN), R15.1
unnamed: D5.A, R23.1
unnamed: Q3.1 (G), R12.1, R13.1
unnamed: AP2305.1 (GATE), C20.2, Q5.3 (D), R17.1
unnamed: D6.A, R24.1
unnamed: Q7.3 (D), R17.2
PM_BIN: R21.2, U$1.37 (P3.3/UCA0TXD/UCA0SIMO), U$9.1 (BIN)
PM_GPOUT: R22.2, U$1.36 (P3.2/UCB0CLK/UCA0STE), U$9.12 (GPOUT)
PM_SCL: R19.2, U$1.35 (P3.1/UCB0SOMI/UCB0SCL), U$9.11 (SCL)
PM_SDA: R20.2, U$1.34 (P3.0/UCB0SIMO/UCB0SDA), U$9.10 (SDA)
PM_SRP: C23.1, R18.1, U$9.7 (SRP), U$11.2
SENSOR_DATA: U$1.2 (P6.1/CB1/A1), U$12.2
SENSOR_EN: Q6.1 (G), U$1.1 (P6.0/CB0/A0)
SPI_CLK: U$1.44 (P4.3/PM_UCB1CLK/PM_UCA1STE), U$8.4 (SCLK)
SPI_MISO: U$1.43 (P4.2/PM_UCB1SOMI/PM_UCB1SCL), U$8.6 (SO)
SPI_MOSI: U$1.42 (P4.1/PM_UCB1SIMO/PM_UCB1SDA), U$8.5 (SI)
SPYBY_RST: JP1.D+, U$1.64 (RST/NMI/SBWTDIO)
SPYBY_TEST: JP1.D-, U$1.59 (TEST/SBWTCK)
UART_RX: U$1.46 (P4.5/PM_UCA1RXD/PM_UCA1SOMI), U$2.14 (UART_TX)
UART_TX: U$1.45 (P4.4/PM_UCA1TXD/PM_UCA1SIMO), U$2.13 (UART_RX)
VCC: AP2305.2 (SOURCE), C2.1, C26.1, C27.1, C28.1, C29.1, L1.2, Q5.2 (S), R1.2, R19.1, R20.1, R21.1, R22.1, R23.2, R24.2, U$1.11 (AVCC1), U$1.15 (DVCC1), U$1.40 (DVCC2), U$2.11 (VCC), U$12.3
VCC_R: C25.1, U$9.2 (REG25), U$9.5 (VCC)
VCC_T: C19.2, Q4.2 (S), R15.2, U$8.31 (VCC), U$8.32 (VDD)
VCOM: C21.1, R11.2, R14.2, U$8.39 (VST), U$8.40 (VOM_PANEL)
VCOM_DRIVER: R11.1, U$8.30 (VCOM_DRIVER)
VDH: C17.2, Q1.3 (D), U$8.36 (VDH)
VDL: C18.2, Q3.2 (S), R12.2, U$8.37 (VDL)
VGH: C15.2, Q2.3 (D), U$8.34 (VGH)
VGL: C16.2, D3.1 (A1), U$8.35 (VGL)
VUSB: C1.1, D1.A, D2.A, D9.A, JP1.VBUS, U$3.6 (USB)
XIN: C32.2, U$1.12 (P5.4/XIN), X1.4
XOUT: C31.1, U$1.13 (P5.5/XOUT), X1.1

Notes on the sheet:
MCU (MSP430F5528)
PWR Management
Bluetooth
Buttons & LED
Sensor
Display
PWR Monitoring
10uH
*micro pwr switch added
*sensor pwr fet added
*fet needs to be tested
*current resistor added
*lower btn & led count to 3

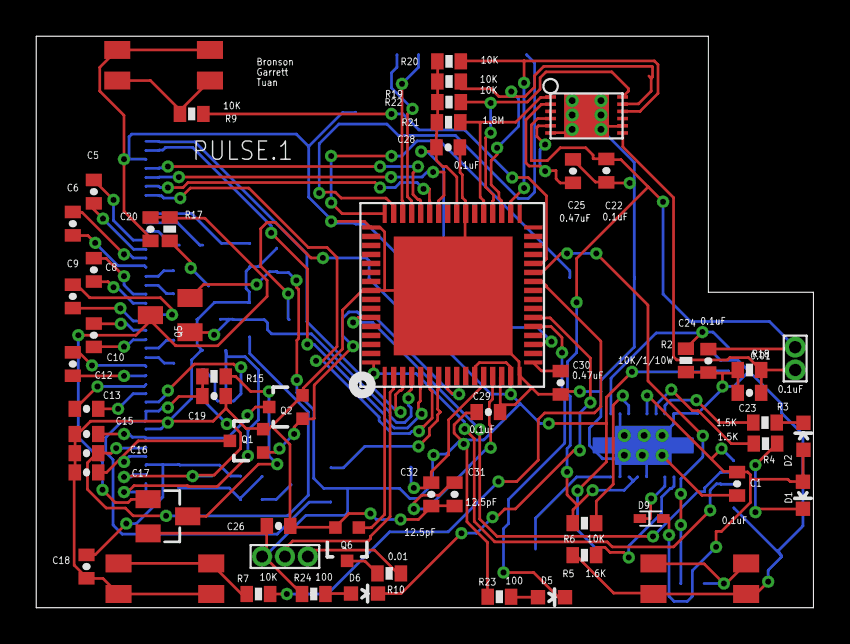
[picture p13: board mainboard.brd from above]

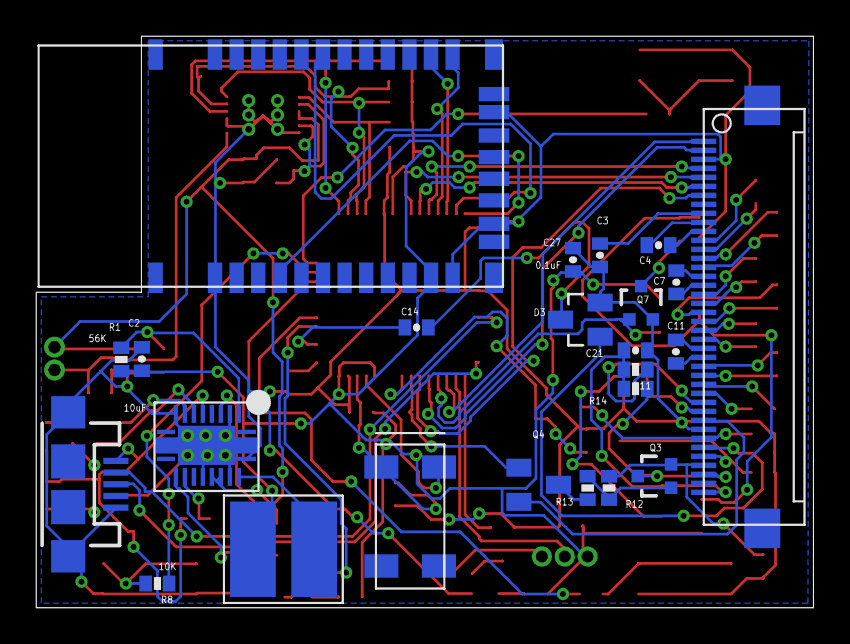
[picture p14: board mainboard.brd from below]

Board: 2 copper layers, 43.2 x 31.8 mm, 82 parts (24 on the bottom side), 87 nets.
