TuanMTruong/Senior_Design/mcu_code/pulse_1/numbers.h

static unsigned char num_0[] = {
0x00,0xE0,0xF8,0xF8,0xFC,0xFC,0xFE,0xFE,
0xFE,0xFF,0xFF,0xFF,0xFF,0xFF,0xFF,0xFF,
0xFF,0xFF,0xFF,0xFF,0xFF,0xFF,0xFE,0xFE,
0xFE,0xFE,0xFC,0xFC,0xF8,0xF8,0xE0,0x00,
0xFF,0xFF,0xFF,0xFF,0xFF,0xFF,0xC3,0x81,
0x81,0x00,0x00,0x00,0x00,0x00,0x00,0x00,
0x00,0x00,0x00,0x00,0x00,0x00,0x81,0x81,
0x81,0xC3,0xFF,0xFF,0xFF,0xFF,0xFF,0xFF,
0x00,0x07,0x1F,0x1F,0x3F,0x3F,0x7F,0x7F,
0x7F,0xFF,0xFF,0xFF,0xFF,0xFF,0xFF,0xFF,
0xFF,0xFF,0xFF,0xFF,0xFF,0xFF,0x7F,0x7F,
0x7F,0x7F,0x3F,0x3F,0x1F,0x1F,0x03,0x00
};

static unsigned char num_1[] = {
0x00,0x00,0x00,0x00,0x00,0x00,0x80,0xF0,
0xFC,0xFC,0xFC,0xFC,0xFC,0x7C,0x1C,0x00,
0x00,0x00,0x00,0x00,0x00,0x00,0x00,0x00,
0x00,0x00,0x00,0x00,0x00,0x00,0x00,0x00,
0xF0,0xF8,0xF8,0xF8,0xF8,0xFF,0xFF,0xFF,
0xFF,0xFF,0xFF,0xFF,0xF9,0xF8,0xF8,0xF8,
0xF8,0xF8,0xF8,0xF8,0xF8,0xF8,0xF8,0xF8,
0xF8,0xF8,0xF8,0xF8,0xF8,0xF8,0xF8,0xF8,
0x07,0x07,0x07,0x07,0x07,0x07,0x07,0x07,
0x07,0x07,0x07,0x07,0x07,0x07,0x07,0x07,
0x07,0x07,0x07,0x07,0x07,0x07,0x07,0x07,
0x07,0x07,0x07,0x07,0x07,0x07,0x07,0x07
};


static unsigned char num_2[] = {
0x00,0xC0,0xF0,0xF8,0xF8,0xFC,0xFC,0xFE,
0xFE,0xFE,0xFE,0x00,0x00,0x00,0x00,0x00,
0x00,0x00,0x00,0x80,0xC0,0xE0,0xF8,0xF8,
0xFC,0xFE,0xFF,0xFF,0xFF,0xFF,0xFF,0xFF,
0xFF,0xFF,0xFF,0xFF,0xFF,0xFF,0x83,0x03,
0x01,0x01,0x01,0x00,0x80,0xC0,0xE0,0xF8,
0xF8,0xFC,0xFF,0xFF,0xFF,0x7F,0x3F,0x3F,
0x1F,0xFF,0xFF,0xFF,0xFF,0xFF,0xFF,0xFF,
0x03,0x1F,0x3F,0x3F,0x7F,0x7F,0xFF,0xFF,
0xFF,0xFF,0xFF,0xFF,0xFF,0x7F,0x7F,0x3F,
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
0x00,0x00,0x00,0x00,0x00,0x00,0x00,0x00,
0x3C,0x3C,0x3C,0x3C,0x3C,0x3C,0x3C,0x3C,
0x3C,0x00,0x00,0x00,0x00,0x00,0x00,0x00,
0x3C,0x3C,0x3C,0x3C,0x3C,0x3C,0x3C,0x3C
};




unsigned char *numbers[] = {
num_0,num_1,num_2,num_3,num_4,num_5,
num_6,num_7,num_8,num_9,colon
};
