TuanMTruong/Senior_Design/proto_blocks/sensor/ADC/lcd_functions.h

void strobe_lcd(void);
void clear_display(void);
void cursor_home(void);
void home_line2(void);
void fill_spaces(void);
void char2lcd(char a_char);
void string2lcd(char *lcd_str);
void lcd_init(void);
