TuanMTruong/Senior_Design/mcu_code/pulse_1/usart.c

/* Author: Garrett Clay
Date: 3.1.2014
Brief: Allow for USART communication from MSP to bluetooth.
*/

/* includes */
#include "msp430.h"
#include "usart.h"

/* decide buffer size for transmit and receive */ 
#define TX_BUFFER_SIZE 5
#define RX_BUFFER_SIZE 20

/*create buffer to hold data and pointer to data */
static volatile char tx_buffer[TX_BUFFER_SIZE];
static volatile char tx_buffer_front;
static volatile char tx_buffer_back;
static volatile char rx_buffer[RX_BUFFER_SIZE];
static volatile char rx_buffer_front;
static volatile char rx_buffer_back;

/* setup usart 8 bit, 1 SB, no parity, 115200 */
void usart_init(void){
	//set data direction
	P4DIR |= USART_TX;
	P4DIR &= ~(USART_RX);
	
	//switch pins from GPIO to USART functionality
	P4SEL |= USART_RX | USART_TX;
	
	UCA1CTL1 |= UCSWRST;	//enable software reset
	UCA1CTL1 |= UCSSEL_2;	//select SMCLK as source
	UCA1CTL0 =  UCMODE_3;	//set no parity, LSB, 8bit, 1SB, ASYNC
	
	UCA1BR0 = 140;		//set buad rate at 115200
	UCA0BR1 = 0x00;
	
	UCA1MCTL |= UCBRS_7 | UCBRF_0;
	
	UCA1CTL1 &= ~(UCSWRST);
	
	UCA1IE |= UCRXIE | UCTXIE; 
}


/* TODO
 * write a function to check if usart has received a char
 * return 1 if there is unread char in receive buffer
 */
char usart_data_avaliable(void){
	char temp = rx_buffer_back;
	if(rx_buffer_front != back){
		return(1);
	}
	return(0);
}



/* put a char in the transmit buffer to await transfer */
void usart_put(char data){
	char i;
	
	i = tx_buffer_front + 1;
	if (i >= TX_BUFFER_SIZE) i = 0;
	while (tx_buffer_back == i) ; // wait until space in buffer
	tx_buffer[i] = data;
	tx_buffer_front = i;
	UCA1IE |=  UCTXIE;
	UCA1IFG |= UCTXIFG;
}

/* grab the latest char from the receive buffer */
char usart_get(void){
	char c, i;
	char back = rx_buffer_back;
	//TODO update timeout if no character is sent or dropped
	//while (rx_buffer_front == back); // wait for character
	if(rx_buffer_front == back){
		return NULL;
	}
	i = rx_buffer_back + 1;
	if (i >= RX_BUFFER_SIZE) i = 0;
	c = rx_buffer[i];
	rx_buffer_back = i;
	return c;
}


#pragma vector=USCI_A1_VECTOR
__interrupt void USCI_A1_ISR(void){
	char i;
	char temp;
	switch(__even_in_range(UCA1IV, 4)){
		case 0: break;
		case 2: //USART Receive data vector
		temp = UCA1RXBUF;
		i = rx_buffer_front + 1;
		if (i >= RX_BUFFER_SIZE) i = 0;
		if (i != rx_buffer_back) {
			rx_buffer[i] = temp;
			rx_buffer_front = i;
		}
		
		
		break;
		case 4: //USART Transmit buffer empty
		temp = tx_buffer_back;
		if (tx_buffer_front == temp) {
			// buffer is empty, disable transmit interrupt
			UCA1IE &= ~(UCTXIE);
		} else {
			i = tx_buffer_back + 1;
			if (i >= TX_BUFFER_SIZE) i = 0;
			while (!(UCA0IFG&UCTXIFG));
			UCA1TXBUF = tx_buffer[i];
			tx_buffer_back = i;
		}
		break;
		default: break;
		
		
	}
}
