TuanMTruong/Senior_Design/mcu_code/pulse_1/0.ASM

;C:\Users\Tuan\Dropbox\0.bmp (24 x 32)
	dt 	0x00,0xC0,0xF0,0xFC,0xFC,0xFE,0xFE,0xFE,0xFF,0x7F,0x3F,0x3F,0x3F,0x3F,0x7F,0xFF,0xFE,0xFE,0xFE,0xFC,0xFC,0xF0,0xC0,0x00
	dt 	0xFE,0xFF,0xFF,0xFF,0xFF,0xFF,0xFF,0xFF,0x01,0x00,0x00,0x00,0x00,0x00,0x00,0x01,0xFF,0xFF,0xFF,0xFF,0xFF,0xFF,0xFF,0xFE
	dt 	0x3F,0xFF,0xFF,0xFF,0xFF,0xFF,0xFF,0xFF,0xC0,0x00,0x00,0x00,0x00,0x00,0x00,0xC0,0xFF,0xFF,0xFF,0xFF,0xFF,0xFF,0xFF,0x3F
	dt 	0x00,0x03,0x0F,0x3F,0x3F,0x3F,0x7F,0x7F,0xFF,0xFE,0xFC,0xFC,0xFC,0xFC,0xFE,0xFF,0x7F,0x7F,0x7F,0x3F,0x3F,0x0F,0x03,0x00
