TuanMTruong/Senior_Design/mcu_code/pulse_1/bt.ASM

;C:\Users\Tuan\Dropbox\bt.bmp (32 x 24)
	dt 	0x00,0x00,0x00,0x00,0x00,0x00,0x00,0x00,0x00,0x00,0x40,0x80,0x00,0x00,0x00,0x00,0x00,0x00,0x80,0x40,0x00,0x00,0x00,0x00,0x00,0x00,0x00,0x00,0x00,0x00,0x00,0x00
	dt 	0x00,0x00,0x08,0x18,0x28,0x48,0x88,0x08,0x08,0x08,0x08,0x88,0x49,0x2A,0x1E,0x0C,0x1A,0x29,0x48,0x88,0x08,0x08,0x08,0x08,0x88,0x48,0x28,0x18,0x08,0x00,0x00,0x00
	dt 	0x00,0x00,0x00,0x00,0x00,0x00,0x00,0x01,0x02,0x02,0x01,0x00,0x00,0x00,0x00,0x00,0x00,0x00,0x00,0x00,0x01,0x02,0x02,0x01,0x00,0x00,0x00,0x00,0x00,0x00,0x00,0x00
