TuanMTruong/Senior_Design/mcu_code/pulse_1/heart.ASM

;C:\Users\Tuan\Dropbox\heart.bmp (32 x 24)
	dt 	0x00,0x00,0x00,0x00,0x00,0x00,0xF0,0xF8,0xF8,0xFC,0xFC,0xFC,0xF8,0xF8,0xF8,0xF0,0xE0,0xE0,0xC0,0x80,0x00,0x00,0x00,0x00,0x00,0x00,0x00,0x00,0x00,0x00,0x00,0x00
	dt 	0x00,0x00,0x00,0x00,0x00,0x00,0x81,0xE7,0xE7,0xFF,0xFF,0xFF,0xFF,0xFF,0xFF,0xFF,0xFF,0xFF,0xFF,0xFF,0xFF,0x7F,0x7E,0x3C,0x3C,0x18,0x18,0x00,0x00,0x00,0x00,0x00
	dt 	0x00,0x00,0x00,0x00,0x00,0x00,0x0F,0x1F,0x1F,0x3F,0x3F,0x3F,0x3F,0x1F,0x1F,0x0F,0x07,0x03,0x03,0x01,0x00,0x00,0x00,0x00,0x00,0x00,0x00,0x00,0x00,0x00,0x00,0x00
