TuanMTruong/Senior_Design/(commit log)

2013-10-20 added battery level indicator to tier 2
2013-10-25 Added list of things for Tuan to look into for the power block
2013-10-31 adding features list table.
    [Features-Garrett.xlsx]
2013-10-31 add more features to the texh table
    [Features-Garrett.xlsx]
2013-10-31 added more smart watches to the tech table
    [Features-Garrett.xlsx]
2013-10-31 re-adding the features document after BRONSON deleted it.
    [Features-Garrett.xlsx]
2013-10-31 added watches to tech table after git pooped on itself and forced me to delete it
    [Features-Garrett.xlsx]
2013-11-06 updated the tech table
    [Features-Garrett.xlsx]
2013-11-14 gave each of us folders to keep our individual docs in so others can view them. probably best if we don't modify eachothers documents
    [Features-Garrett.xlsx]
2013-11-21 moved documents around to clean up
    [Features-Garrett.xlsx]
2013-11-21 WIP: added SPI send byte and send COG packet data
2013-11-23 WIP: PWM
2013-11-25 added comments about potential bugs. Will review these with Tuan today (11.25)
    [main.c]
2013-12-08 added pwr management prototype board files
    [pwr_block.brd, pwr_block.sch]
2013-12-09 updated schematic pic
2013-12-09 added Bill of material
    [BOM.xlsx]
2013-12-11 more files woohoo
    [BOM.xlsx, mcu_block.sch, pwr_block.brd, pwr_block.sch]
2013-12-18 Updated several functions. Specifically SPI_sendbyte() and SPI_sendpacket(). Cleaned up several functions that had noticable errors. Updated hardware configuration to at90usb but now it needs to be u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
    [main.c]
2013-12-18 Updated COG init function. PWM needs to be updated still. Other small updates.
2013-12-21 /******************************************/ // The following information is for Garrett /******************************************/
    // Line 78 & 79: #define can't start with numbers so 4_1IN_DATA
    // won't work. It has been temporarily changed to IN_DATA. Will
    // come back to deal with this later.
    //
    // Some functions names have been changed to clarify understanding
    // function purpose. For example SPI_byte and SPI_bytes is now
    // COG_sendbyte and COG_sendarray. This the format of naming
    // functions: module_action. In this case the data is for the COG
    // so the module is the COG and the action is to send either a
    // byte or an array.
    //
    // I will apply this format to startup_cog and change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
    [main.c]
2013-12-21 -Change image buffer to a 2D array -update fill image buffer function for 2D array
    [mcu_block.job.brd]
2013-12-22 Sensor board revision #2. First board. This copy is for Tuan to review and critique before its ordered. There will likely be changes made so this copy will be outdated. Garrett will keep track of the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
    [sensor_2.brd, sensor_2.sch]
2013-12-23 // added a trace restricted area for sensor plane // reorganized parts for optimal space and routing
    [sensor_2.brd]
2013-12-23 // add negative soldermask area for sensor plane
    [sensor_2.brd]
2013-12-27 routed and sent out to fab for prototype
    [pwr_block.brd, pwr_block.sch]
2013-12-27 add buttons
    [mcu_block.sch]
2013-12-31 NYE update epd: pwm and spi fixed, added usart debug messages currently stuck on creating and sending image
    mcu board: finished and sent out
    pwr mgn: finished and sent out
    (lack pwr monitoring feature)
    [main.c, usart.c, usart.h]
2013-12-31 epd issue found: AVR ran out of memeory -_- need to not make gigantic arrays, it was over writing spots of memories it probably shouldn't have.
    [main.c]
2014-01-02 IC3 had green lines that were part of the via layer. Those were removed. There was also a missing trace from PIN2 of the IC3 part. That was restored. Small tweaks were made. Sensor board seems to be 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
    [sensor_2.brd, sensor_2.sch]
2014-01-02 Routed previously missed airwire. Submitting to OHSpark next.
    [sensor_2.brd]
2014-01-12 Added a breakout board files for Bluetooth module
    [bt_441.brd, bt_441.sch]
2014-01-13 Moved some text from bottom layer to top layer
    [bt_441.brd]
2014-01-13 Small things changed. COG_startup(), COG_init(), COG_write_fixed_image(), COG_off() all confirmed logically correct. PWM confirmed around 140mhz which is between 100&300mhz so check. SPI freq is at 8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
    [COG.c, COG.h, main.c]
2014-01-13 USART debug added to the COG_write_fixed_line(). Should display all image bits. Next need to run with USART plugged in to verify transmition is correct.
    [COG.c]
2014-01-18 Removed debug lines that Tuan liked so much. Didn't make any major changes. Confirmed that write_fixed_image() is working correctly using USART. Need to verify spi is sending appropriately using osco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
    [COG.c, main.c, spi.c]
2014-01-19 Small changes to be more like Arduino version.
2014-01-23 Added arduino/MSP430 code.
2014-02-09 Hopefully this only updates the arduino code file. Current version can take three images rather than two. The third image is 24x28 and intended to be the size of a time digit. Next to be done is actu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
    [EPD_BOM.xlsx]
2014-02-18 added the block test code for usart and spi
2014-02-19 Working copy of Arduino code. Updated EPD.cpp, EPD.h, demo.ino and image files.
2014-02-19 started board files
    [mainboard.brd, mainboard.sch]
2014-02-20 cleaned up schematic
    [mainboard.brd, mainboard.sch]
2014-02-20 Start of mcu code using IAR tool. SPI is only converted code at this point.
2014-02-21 added the buttons garrett wanted
    [mainboard.brd, mainboard.sch]
2014-02-23 Completed EPD connector schematic needs to be reviewed before sent out
    [mainboard.brd, mainboard.sch]
2014-02-25 It compiles! Fixed bugs. Need to figure out how to set MSP430 clock. Section 5.1 of User Guide seems to be the answer. Figure this out, review TODOs once more, then load it up and start the debug.
    [epd.c, main.c, spi.c]
2014-02-25 stuff and things were updated
    [mainboard.brd, mainboard.sch]
2014-02-26 deleted some NC parts
    [mainboard.sch]
2014-02-27 Finished the routing and shipped the board out
    [mainboard.brd, mainboard.sch]
2014-02-27 clean up lib and added gerbers
2014-02-27 updated some values
    [mainboard.sch]
2014-03-02 pwm, spi, and usart works now.
2014-03-04 created a back up test board for check off
    [base_backup.1.brd, base_backup.1.sch, mainboard.brd, mainboard.job.brd, mainboard.sch]
2014-03-05 udated adc
2014-03-08 created a back up board
    [bt_441-bcream.dxf, bt_441-tcream.dxf, mainboard.brd, mcu_block.job-bcream.dxf, mcu_block.job-tcream.dxf, pwr_block-bcream.dxf, pwr_block-tcream.dxf]
2014-03-16 added code for pulse watch This code was used for winter term final check off Still have memory issues and get stuck in receiving time stamp needs LPM added.
    [0.ASM, 1.ASM, 2.ASM, 3.ASM, 4.ASM, 5.ASM, 6.ASM, 7.ASM]
2014-03-20 starting next rev
    [mainboard.brd, mainboard.sch]
2014-03-27 updated schematic for rev1
    [mainboard.job.brd]
2014-04-10 made rev2 which is smaller than rev1
    [mainboard.brd, mainboard.sch]
2014-04-25 updated rev2 board with part values
    [mainboard.brd, mainboard.sch, mcu_block.brd]
2014-05-24 Cleaned things up a bit
    [BOM.xlsx, EPD_BOM.xlsx, Features-Garrett.xlsx, base_backup.1.brd, base_backup.1.sch, bt_441-bcream.dxf, bt_441-tcream.dxf, bt_441.brd]
